Smeat/solder_station/doc/pictures/board.jpg

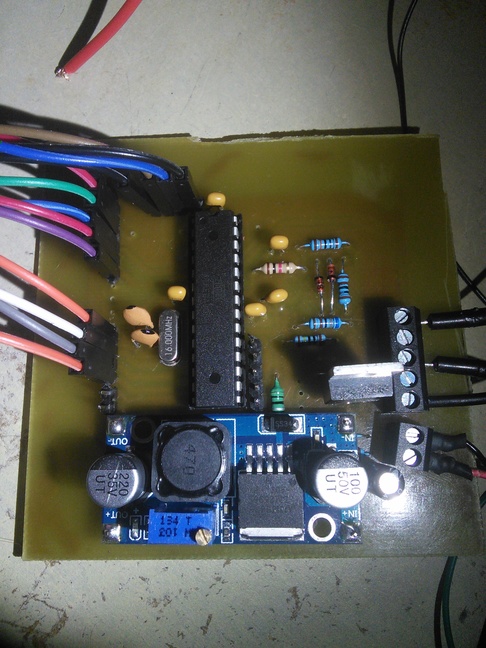
doc/pictures/board.jpg
