Smeat/solder_station/README

The content of the "scad" folder is licensed under the CC-BY-SA-NC 4.0.
The rest, if not stated otherwise, is licensed under the GPLv3.
