Smeat/solder_station/Firmware/README

To use this you have to provide your own library for button detection.
