Smeat/solder_station/doc/ui/ui.pdf

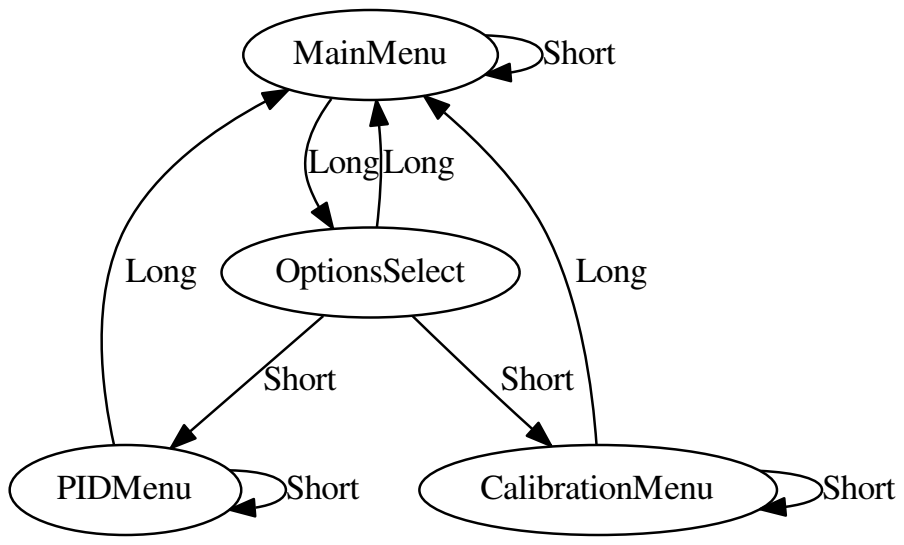
[picture p2: figure]
MainMenu; Short; OptionsSelect; LongLong; PIDMenu; CalibrationMenu; Long
