Smeat/solder_station/scad/stl/TShell.stl

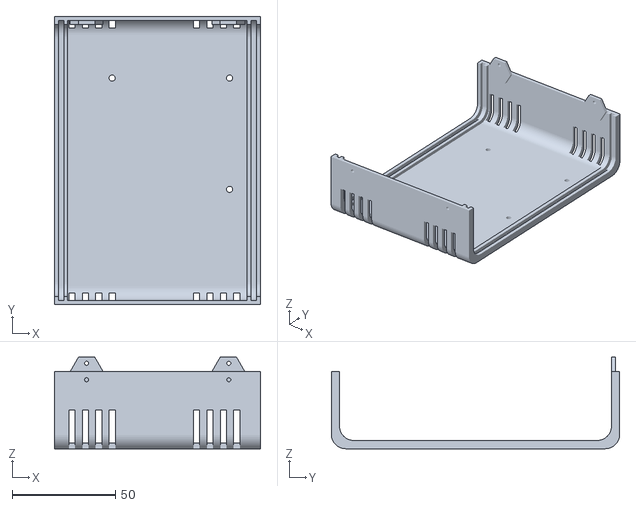
[picture p3: CAD file, 2016-02-08]
scad/stl/TShell.stl
100.0 x 140.0 x 44.4
