Smeat/solder_station/scad/stl/Text.stl

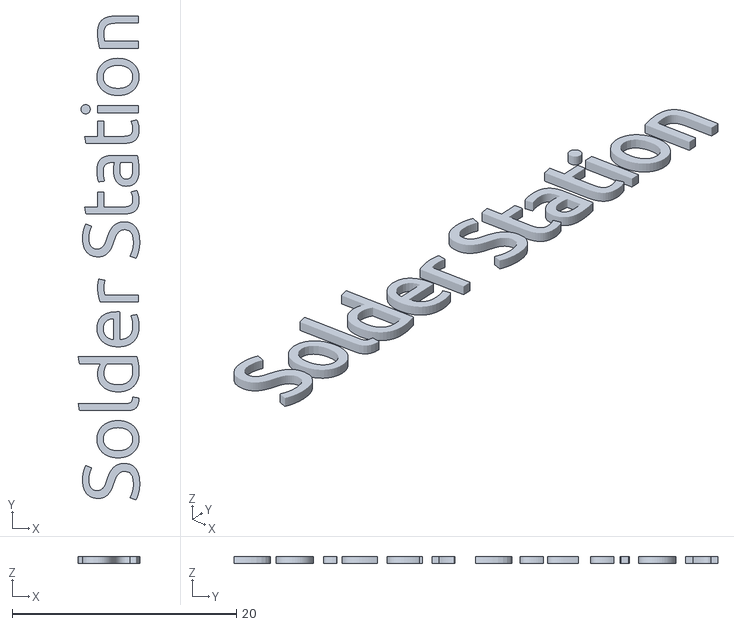
[picture p4: CAD file, 2016-02-08]
scad/stl/Text.stl
5.50 x 43.1 x 0.6
