Smeat/solder_station/scad/stl/BShell.stl

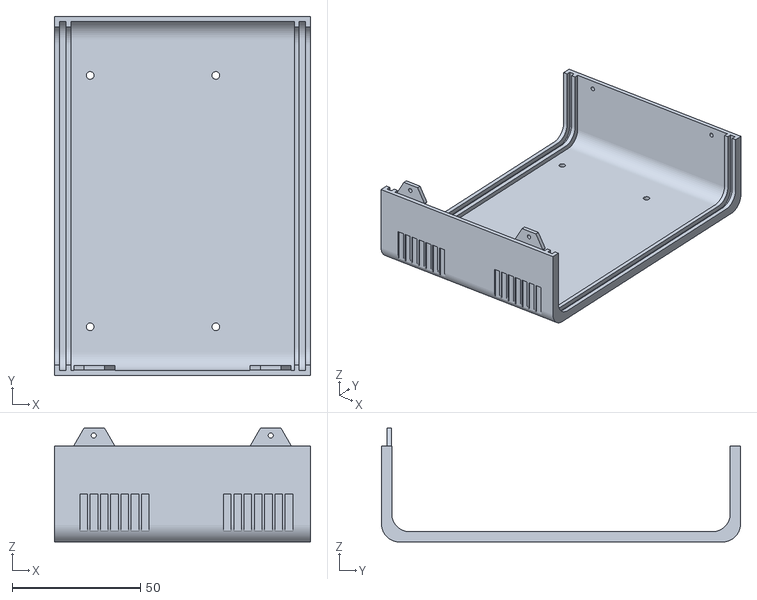
[picture p5: CAD file, 2016-02-08]
scad/stl/BShell.stl
100.0 x 140.0 x 44.4
