Smeat/solder_station/scad/stl/FPanel.stl

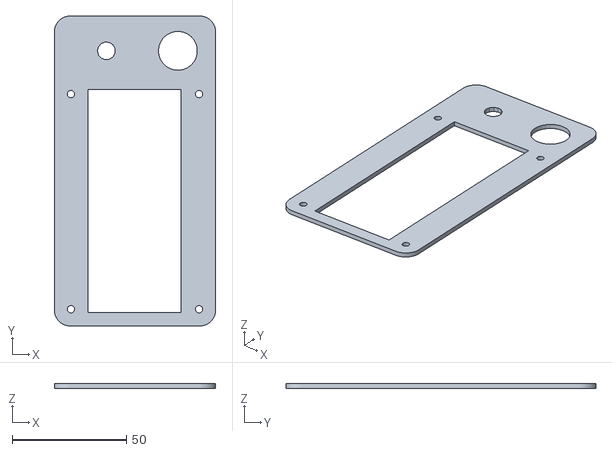
[picture p6: CAD file, 2016-02-08]
scad/stl/FPanel.stl
70.5 x 135.5 x 2.00
