Smeat/solder_station/scad/stl/BPanel.stl

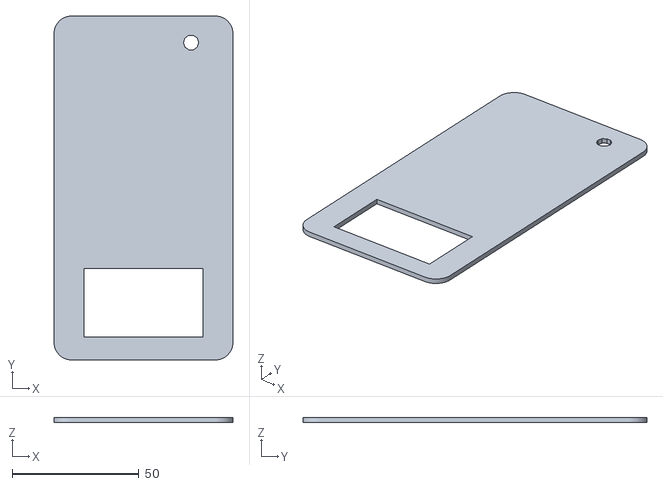
[picture p7: CAD file, 2016-02-08]
scad/stl/BPanel.stl
70.5 x 135.5 x 2.00
