Smeat/solder_station/scad/conf/active_userconfig.scad

include <myconfig.scad>
