Smeat/solder_station/(list of files, cad)

Other CAD files:
scad/vitamins/gx16.scad
