Smeat/solder_station/(threads)

Thread 2 (2016-02-23):

Button implementation is missing

Smeat, 2016-02-23:
