Smeat/solder_station/kicad/solder_station.pdf

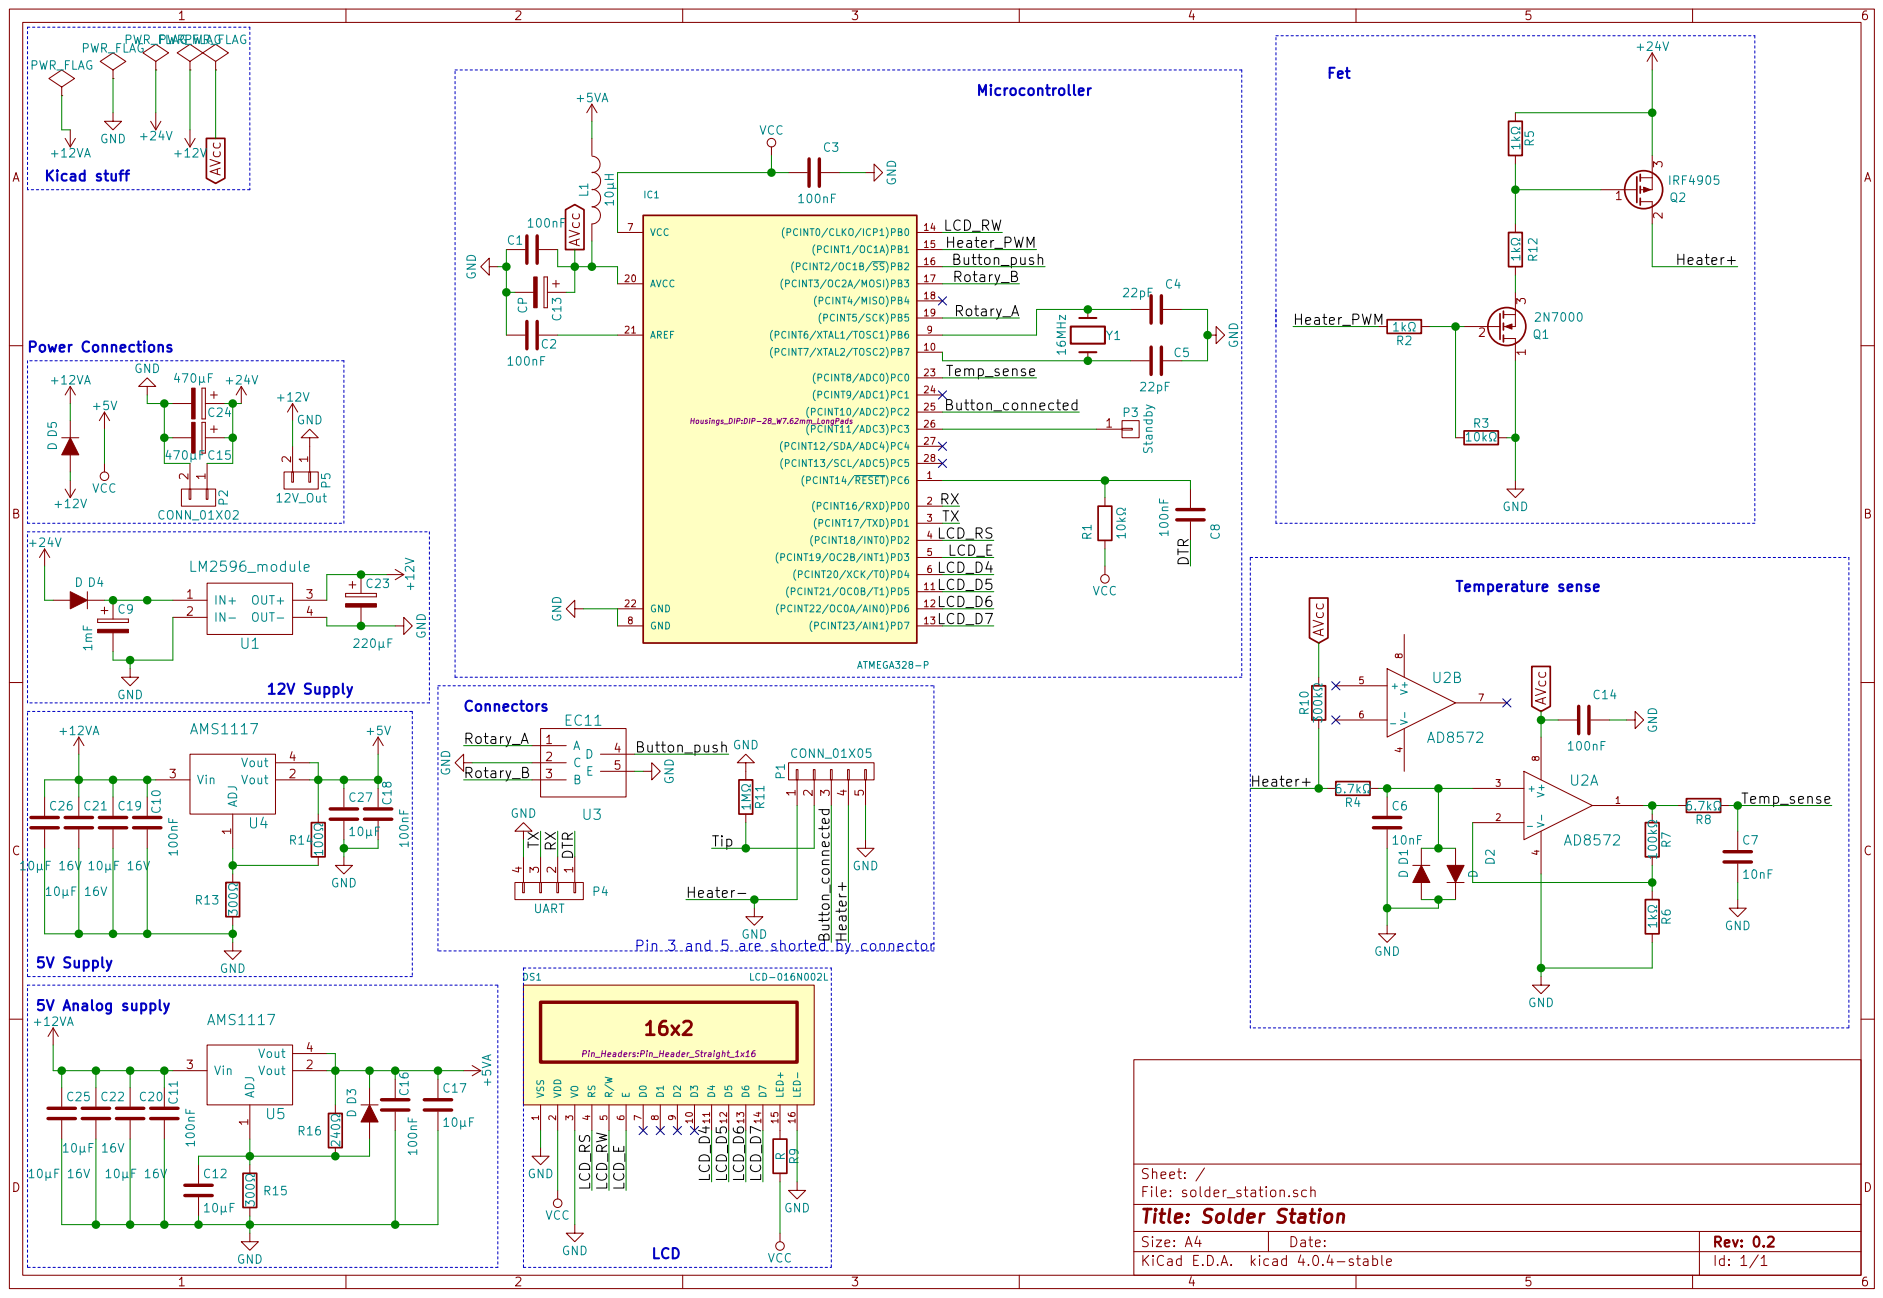
[picture p8: page 1]

1 P4 UART GND C8100nF GND D1 D D2 D R10 300k AVcc 1MR11 Heater- Tip

Pin 3 and 5 are shorted by connector

9 D3 10 D4 11 D5 12 D6 13 D7 14 LED+ 15 LED- 16 DS1 LCD-016N002L Pin_Headers:Pin_Header_Straight_1x16 GND GND

File: solder_station.sch Sheet: /
Id: 1/1 Title: Solder Station
