Smeat/solder_station/kicad/solder_station.kicad_pcb

## KiCad design kicad/solder_station.kicad_pcb (2016-11-06)

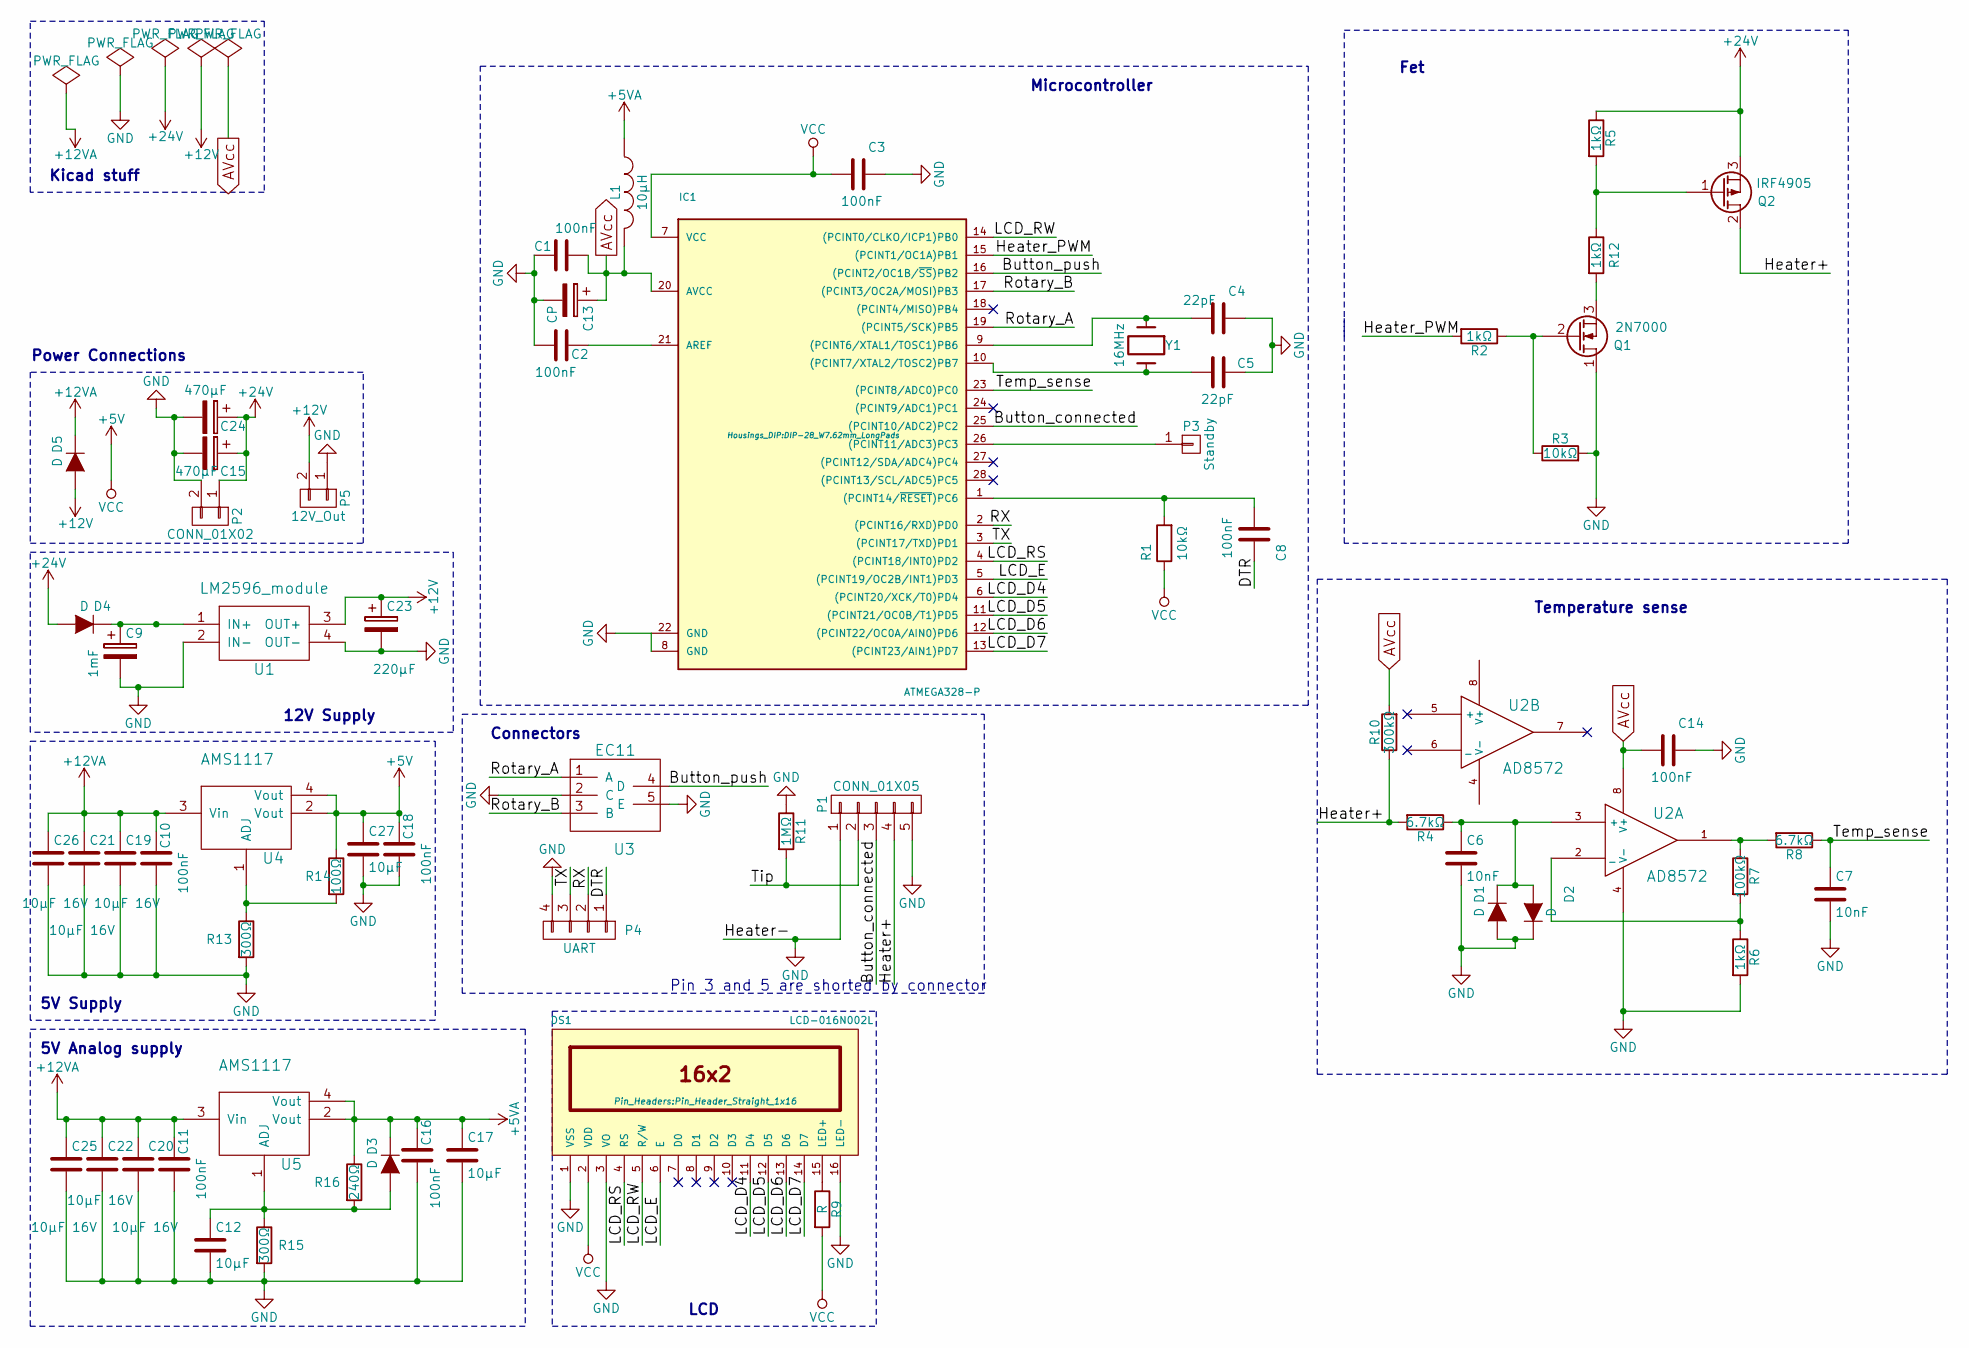
[picture p9: schematic solder_station.sch, Solder Station]

Parts:
C1, C2, C3, C8, C10, C11, C14, C16, C18: 100nF; C_0603
C4, C5: 22pF; C_Disc_D3_P2.5
C6, C7: 10nF; C_0603
C9: 1mF; C_Radial_D10_L25_P5
C12, C17, C27: 10µF; C_0603
C13: CP; C_Radial_D6.3_L11.2_P2.5
C15, C24: 470µF; C_Radial_D6.3_L11.2_P2.5
C19, C20, C21, C22, C25, C26: 10µF 16V; C_0805
C23: 220µF; C_Radial_D6.3_L11.2_P2.5
D1, D2, D3, D4, D5: D; Diode_DO-35_SOD27_Horizontal_RM10
DS1: LCD-016N002L; Pin_Header_Straight_1x16
IC1: ATMEGA328-P; DIP-28_W7.62mm_LongPads
L1: 10µH; Choke_Horizontal_RM10mm
P1: CONN_01X05; TerminalBlock_Pheonix_MKDS1.5-5pol
P2: CONN_01X02; TerminalBlock_Pheonix_MKDS1.5-2pol
P3: Standby; Pin_Header_Straight_1x01
P4: UART; Pin_Header_Straight_1x04
P5: 12V_Out; Pin_Header_Angled_1x02
Q1: 2N7000; TO-92_Inline_Wide
Q2: IRF4905; TO-220_Neutral123_Vertical
R1: 10kΩ; Resistor_Horizontal_RM10mm
R2, R5, R12: 1kΩ; Resistor_Horizontal_RM10mm
R3: 10kΩ; R_0805
R4: 6.7kΩ; R_0805_HandSoldering
R6: 1kΩ; R_0805
R7: 100kΩ; R_0805
R8: 6.7kΩ; Resistor_Horizontal_RM7mm
R9: R; Resistor_Horizontal_RM10mm
R10: 300kΩ; Resistor_Horizontal_RM10mm
R11: 1MΩ; R_0805
R13, R15: 300Ω; R_0805
R14: 100Ω; R_0805
R16: 240Ω; R_0805
U1: LM2596_module; LM2596
U2: AD8572; SOIC-8_3.9x4.9mm_Pitch1.27mm
U3: EC11; Pin_Header_Straight_1x05
U4, U5: AMS1117; SOT-223
Y1: 16MHz; HC-49V

Connections:
+5V: C3.2, C18.1, C27.1, DS1.2 (VDD), IC1.7 (VCC), R1.1, R9.2, R14.1, U4.2 (Vout), U4.4 (Vout)
+5VA: C16.1, C17.1, D3.1 (K), L1.1, R16.1, U5.2 (Vout), U5.4 (Vout)
+12V: C23.1, D5.2 (A), P5.2, U1.3 (OUT+)
+12VA: C10.1, C11.1, C19.1, C20.1, C21.1, C22.1, C25.1, C26.1, D5.1 (K), U4.3 (Vin), U5.3 (Vin)
+24V: C15.1, C24.1, D4.2 (A), P2.1, Q2.3 (S), R5.1
/Button_connected: IC1.25 ((PCINT10/ADC2)PC2), P1.3
/Button_push: IC1.16 ((PCINT2/OC1B/~SS~)PB2), U3.4 (D)
/DTR: C8.1, P4.1
/Heater+: P1.4, Q2.2 (D), R4.2, R10.1
/Heater_PWM: IC1.15 ((PCINT1/OC1A)PB1), R2.2
/LCD_D4: DS1.11 (D4), IC1.6 ((PCINT20/XCK/T0)PD4)
/LCD_D5: DS1.12 (D5), IC1.11 ((PCINT21/OC0B/T1)PD5)
/LCD_D6: DS1.13 (D6), IC1.12 ((PCINT22/OC0A/AIN0)PD6)
/LCD_D7: DS1.14 (D7), IC1.13 ((PCINT23/AIN1)PD7)
/LCD_E: DS1.6 (E), IC1.5 ((PCINT19/OC2B/INT1)PD3)
/LCD_RS: DS1.4 (RS), IC1.4 ((PCINT18/INT0)PD2)
/LCD_RW: DS1.5 (R/W), IC1.14 ((PCINT0/CLKO/ICP1)PB0)
/RX: IC1.2 ((PCINT16/RXD)PD0), P4.2
/Rotary_A: IC1.19 ((PCINT5/SCK)PB5), U3.1 (A)
/Rotary_B: IC1.17 ((PCINT3/OC2A/MOSI)PB3), U3.3 (B)
/TX: IC1.3 ((PCINT17/TXD)PD1), P4.3
/Temp_sense: C7.1, IC1.23 ((PCINT8/ADC0)PC0), R8.1
/Tip: P1.2, R11.2
AVcc: C1.2, C13.1, C14.2, IC1.20 (AVCC), L1.2, R10.2, U2.8 (V+)
GND: C1.1, C2.2, C3.1, C4.1, C5.1, C6.2, C7.2, C9.2, C10.2, C11.2, C12.2, C13.2, C14.1, C15.2, C16.2, C17.2, C18.2, C19.2, C20.2, C21.2, C22.2, C23.2, C24.2, C25.2, C26.2, C27.2, D1.2 (A), D2.1 (K), DS1.1 (VSS), DS1.3 (VO), DS1.16 (LED-), IC1.8 (GND), IC1.22 (GND), P1.1, P1.5, P2.2, P4.4, P5.1, Q1.1 (D), R3.2, R6.2, R11.1, R13.2, R15.2, U1.2 (IN-), U1.4 (OUT-), U2.4 (V-), U3.2 (C), U3.5 (E)
unnamed: C2.1, IC1.21 (AREF)
unnamed: C4.2, IC1.9 ((PCINT6/XTAL1/TOSC1)PB6), Y1.1
unnamed: C5.2, IC1.10 ((PCINT7/XTAL2/TOSC2)PB7), Y1.2
unnamed: C6.1, D1.1 (K), D2.2 (A), R4.1, U2.3 (+)
unnamed: C8.2, IC1.1 ((PCINT14/~RESET~)PC6), R1.2
unnamed: C9.1, D4.1 (K), U1.1 (IN+)
unnamed: C12.1, D3.2 (A), R15.1, R16.2, U5.1 (ADJ)
unnamed: DS1.15 (LED+), R9.1
unnamed: IC1.26 ((PCINT11/ADC3)PC3), P3.1
unnamed: Q1.2 (G), R2.1, R3.1
unnamed: Q1.3 (S), R12.2
unnamed: Q2.1 (G), R5.2, R12.1
unnamed: R6.1, R7.2, U2.2 (_)
unnamed: R7.1, R8.2, U2.1
unnamed: R13.1, R14.2, U4.1 (ADJ)

Notes on the sheet:
Pin 3 and 5 are shorted by connector
5V Analog supply
5V Supply
12V Supply
Power Connections
Kicad stuff
Microcontroller
Connectors
LCD
Fet
Temperature sense

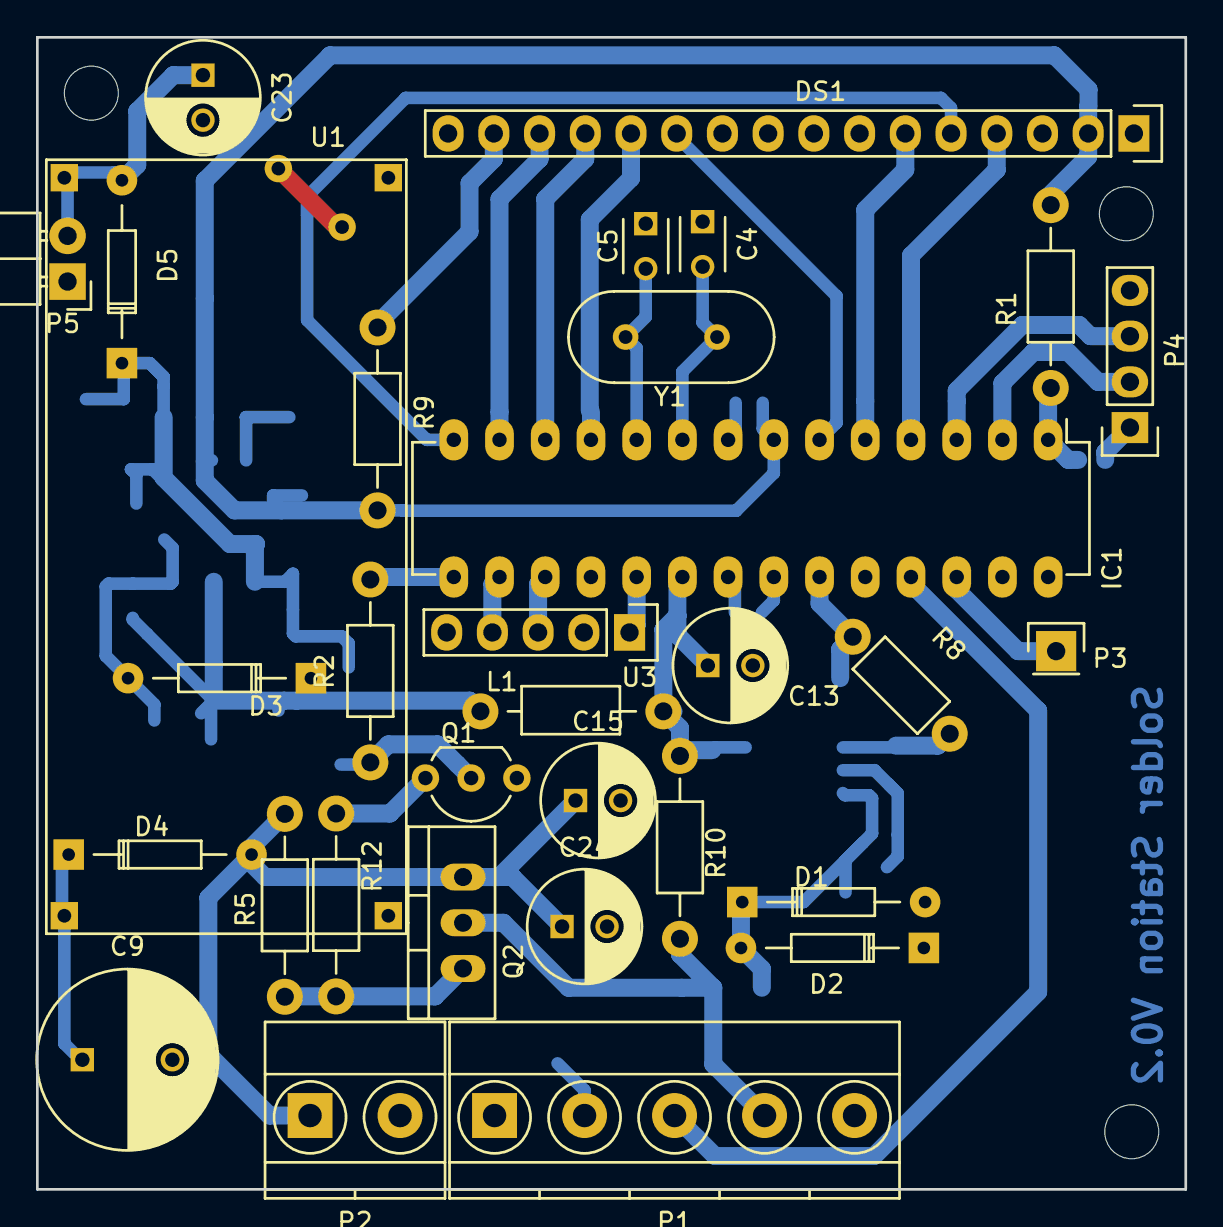
[picture p10: board solder_station.kicad_pcb from above]

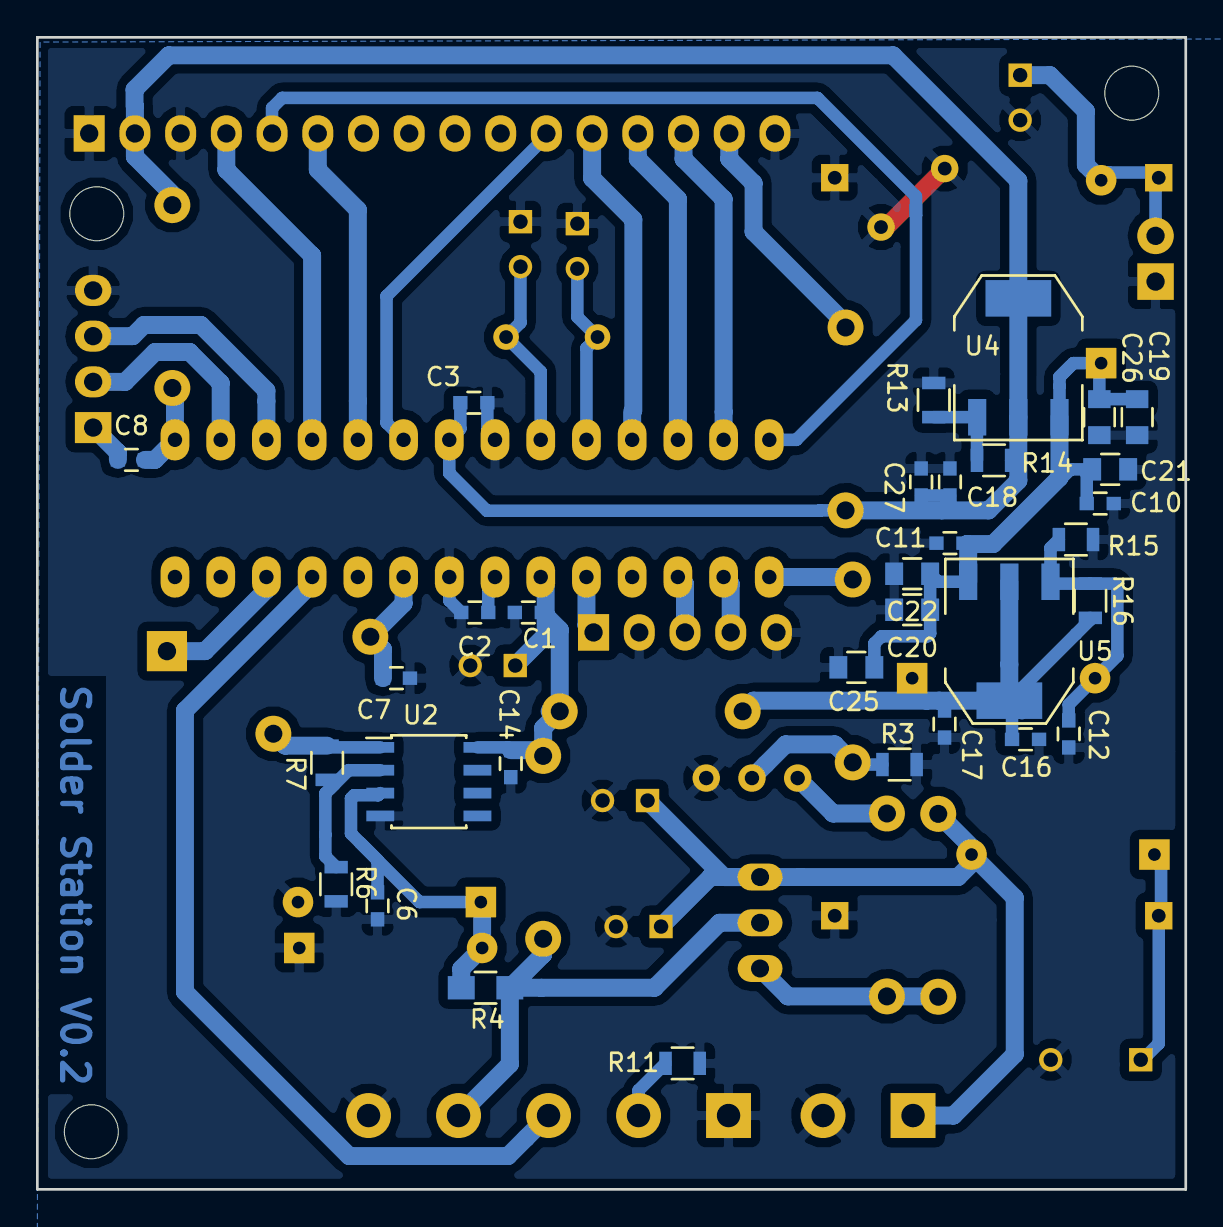
[picture p11: board solder_station.kicad_pcb from below]

Board: 2 copper layers, 63.8 x 64.0 mm, 67 parts (32 on the bottom side), 40 nets.

Other parts of the board:
Hole1, Hole1#2, Hole3: MountingHole_3mm
