Smeat/solder_station/Firmware/src/main.c

/**
This file is part of SolderStation.

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
You should have received a copy of the GNU General Public License
along with SolderStation.  If not, see <http://www.gnu.org/licenses/>.
**/


#include <avr/io.h>
#include <util/delay.h>
#include <avr/interrupt.h>
#include <avr/eeprom.h>

#include <inttypes.h>
#include <stdio.h>
#include <stdlib.h>

#include "../lib/Timer.h"

#include "constants.h"
#include "adc.h"
#include "button.h"

#ifdef LCD_SUPPORT
#include "../lib/lcd/lcd.h"
#endif

#ifdef UART_DEBUG
#include <uart.h>
#endif

#define ROTATE_A ((ROTATE_PIN & (1 << ROTATE_A_PIN)) == 0)
#define ROTATE_B ((ROTATE_PIN & (1 << ROTATE_B_PIN)) == 0)
#define ROTATE_C ((ROTATE_PIN & (1 << ROTATE_C_PIN)) == 0)

#define BUTTON_STANDBY ((BUTTON_STANDBY_PIN_REGISTER & (1 << BUTTON_STANDBY_PIN)) == 0)

#define BUTTON_CONNECTED ((BUTTON_CONNECTED_PIN_REGISTER & (1 << BUTTON_CONNECTED_PIN)) == 0)

uint16_t targetTemp = 0;
uint16_t defaultTemp = 250;
uint16_t standByTemp = 180;
uint16_t lastTemp = 0;


uint16_t EEMEM ee_standByTemp = 180;
uint16_t EEMEM ee_defaultTemp = 250;

float Kp = DEFAULT_KP;
float Ki = DEFAULT_KI;
float Kd = DEFAULT_KD;

float ee_Kp EEMEM = DEFAULT_KP;
float ee_Ki EEMEM = DEFAULT_KI;
float ee_Kd EEMEM = DEFAULT_KD;

float adc_temp_factor = DEFAULT_FACTOR;
int16_t adc_temp_constant = DEFAULT_CONSTANT;

float ee_adc_temp_factor EEMEM = DEFAULT_FACTOR;
int16_t ee_adc_temp_constant EEMEM = DEFAULT_CONSTANT;

float Ki_time = 0;
float Kd_time = 0;
volatile int8_t rotary_value;

uint8_t current_menu = MENU_MAIN;
uint8_t menu_pos = 0;
uint8_t output_enabled = 0;

void setPWM(int16_t val){
	OCR1A = val;
}

#ifdef UART_DEBUG
int uart_putchar(char c, FILE* stream){
	uart_putc(c);
	return 0;
}
#endif

int8_t read_rotary(){
	cli();
	int8_t value = rotary_value;
	rotary_value = value & 0b0011; //save lower bits (e.g. if function returns values less than 4)
	sei();
	return value >> 2;
}

void enableHeater(){
	if(output_enabled){
		TCCR1A |= (1 << COM1A1);
	}
}

void disableHeater(){
	TCCR1A &= ~(1 << COM1A1);
}

uint16_t getTemperature(){
	disableHeater();
	_delay_ms(HEATER_WAIT_DELAY);

	uint16_t avg_adc = read_adc_avg(0, 5);
	float voltage = avg_adc * (1.1 / 1023.0);
	char s[8];
	dtostrf( voltage, 6, 3, s );

	uint16_t temperature = avg_adc * adc_temp_factor + adc_temp_constant;
#ifdef UART_DEBUG_TEMP
	printf("Temp: %u Voltage %s\n", avg_adc, s);
#endif

	enableHeater();

	lastTemp = temperature; //save last temp for display

	return temperature;
}

uint16_t calculatePID(uint16_t target, uint16_t is){
	static uint16_t oldError = 0;
	static float iterm = 0;

	int16_t error = target - is;

	float pterm = Kp * error;
	float dterm = Kd_time * (int16_t)((int16_t)error - (int16_t)oldError);

	if(((pterm + iterm + dterm) < MAX_PWM) && ((pterm + iterm + dterm) > -MAX_PWM)){
		iterm += (Ki_time * error);
	}

	if(error > abs(20)){ //set I to 0 if error is too big
		iterm = 0;
	}

	float output = pterm + iterm + dterm;

	if(output > MAX_PWM) output = MAX_PWM;
	if(output < 0) output = 0;

	oldError = error;

#ifdef UART_DEBUG_PID
	printf("Error: %i ||", error);
	char s[8];
	dtostrf( pterm, 6, 3, s );
	uart_puts(s);
	uart_puts(" + ");
	dtostrf( iterm, 6, 3, s );
	uart_puts(s);
	uart_puts(" + ");

	dtostrf( dterm, 6, 3, s );
	uart_puts(s);
	uart_puts(" = ");
	dtostrf( output, 6, 3, s );
	uart_puts(s);
	uart_puts("\n");
#endif

	return (uint16_t)output;
}

uint8_t isStandby(){
	return BUTTON_STANDBY; //TODO: read button
}

void updateOuput(){
	uint16_t output = calculatePID((isStandby() ? standByTemp : targetTemp), getTemperature());
	setPWM(output);

	if(lastTemp > 400){ //TODO: make variable
		disableHeater();
	}
}

void precalcPID(){
	Ki_time = Ki * updateTime;
	Kd_time = Kd / updateTime;
}

#ifdef LCD_SUPPORT
void init_lcd(){
	lcd_init(LCD_DISP_ON);
	lcd_clrscr();

	lcd_add_custom_character_P(CHARACTER_THERMOMETER, char_thermometer);
	lcd_add_custom_character_P(CHARACTER_DEGREE, char_degree);
	lcd_add_custom_character_P(CHARACTER_KP, char_kp);
	lcd_add_custom_character_P(CHARACTER_KI, char_ki);
	lcd_add_custom_character_P(CHARACTER_KD, char_kd);
	lcd_add_custom_character_P(CHARACTER_PLAY, char_play);
	lcd_add_custom_character_P(CHARACTER_PAUSE, char_pause);
}
#endif

void init_timer(){
	//1ms timer2 TODO: alternative use main loop and millis()?
	TCCR2A = (1 << WGM21); //CTC
	TCCR2B = (1 << CS20) | (1 << CS21); // /64 prescaler
	OCR2A = 250; // 1 ms
	TIMSK2 = (1 << OCIE2A); //enable compare A

	// PWM
	DDRB |= (1 << PB1); //enable output
	TCCR1A = (1<<WGM10) | (1<<WGM11) | (1<<COM1A1); // 10bit-Counter, FastPWM
	TCCR1B =  (1 << CS10) | (1 << CS12) | (1 << WGM12); // 64 prescaler -> 244hz

	init_timer0();

	disableHeater();

	sei();
}

#ifdef LCD_SUPPORT
void updateDisplay(){
	lcd_clrscr();
	lcd_home();
	char menu_string[60];
	uint8_t cursor_end_pos[2] = {0,0};
	if(current_menu == MENU_MAIN){
		lcd_command(LCD_DISP_ON);
		lcd_puts_P("Solder Station 0.1");
		lcd_gotoxy(0,1);

		sprintf(menu_string, "%c%-3u/%-3u%cC \n"
							 "%c\n"
							  "PWM: %-4u\n",
							  CHARACTER_THERMOMETER, lastTemp, targetTemp, CHARACTER_DEGREE, output_enabled ? CHARACTER_PLAY : CHARACTER_PAUSE, output_enabled ? OCR1A : 0);
	}
	else if (current_menu == MENU_OPTIONS_PID){
		lcd_command(LCD_DISP_ON_CURSOR);

		char kp[8], ki[8], kd[8];
		dtostrf( Kp, 6, 1, kp );
		dtostrf( Ki, 6, 2, ki );
		dtostrf( Kd, 6, 1, kd );


		sprintf(menu_string, "PID Setting\n"
							 "%c%-3u/%-3u%cC\n"
							 "%c:%-3s %c:%-3s \n%c:%-3s\n",  CHARACTER_THERMOMETER, lastTemp, targetTemp, CHARACTER_DEGREE,
							 	 	 	 	 	   CHARACTER_KP, kp, CHARACTER_KI, ki, CHARACTER_KD, kd);

		if(menu_pos == 0){ //TODO: make me better. array?
			cursor_end_pos[0] = 7;
			cursor_end_pos[1] = 2;
		}
		else if(menu_pos == 1) {
			cursor_end_pos[0] = 16;
			cursor_end_pos[1] = 2;
		}
		else if(menu_pos == 2){
			cursor_end_pos[0] = 7;
			cursor_end_pos[1] = 3;
		}
	}
	else if (current_menu == MENU_CONNECTED){
		sprintf(menu_string,"Error!\nSolder iron\nnot connected!!\nPlease connect!\n");
	}
	else if (current_menu == MENU_OPTIONS_SELECT){
		sprintf(menu_string, "Select Menu:\n"
				"%s", option_menus[menu_pos]);
	}
	else if (current_menu == MENU_OPTIONS_CALIBRATE){
		lcd_command(LCD_DISP_ON_CURSOR);
		char factor[8];
		dtostrf( adc_temp_factor, 6, 3, factor );

		sprintf(menu_string, "Calibration\n"
							 "%c%-3u/%-3u%cC\n"
							 "Factor: %s\n"
							 "Constant: %i",
							 CHARACTER_THERMOMETER, lastTemp, targetTemp, CHARACTER_DEGREE,
							 factor, adc_temp_constant);
		if(menu_pos == 0){
			cursor_end_pos[0] = 13;
			cursor_end_pos[1] = 2;
		}
		else if(menu_pos == 1){
			cursor_end_pos[0] = 11;
			cursor_end_pos[1] = 3;
		}
	}
	else if(current_menu == MENU_OPTIONS_RESET){
		sprintf(menu_string, "Reset defaults\n"
							 "Are you sure?\n"
							 "Press long to abort\n"
							 "%s  %s  %s", (menu_pos) == 1 ? "2" : "", (menu_pos) == 2 ? "1" : "", (menu_pos) == 3 ? "0" : "");
	}
	else if(current_menu == MENU_OPTIONS_TEMP){
		lcd_command(LCD_DISP_ON_CURSOR);
		sprintf(menu_string,"Set temperatures\n"
							"StartTemp: %-3u%cC\n"
							"Standby: %-3u%cC", defaultTemp, CHARACTER_DEGREE, standByTemp, CHARACTER_DEGREE);
		if(menu_pos == 0){
			cursor_end_pos[0] =  13;
			cursor_end_pos[1] = 1;
		}
		if(menu_pos == 1){
			cursor_end_pos[0] =  11;
			cursor_end_pos[1] = 2;
		}
	}

	lcd_puts(menu_string);
	lcd_gotoxy(cursor_end_pos[0],cursor_end_pos[1]);
}
#endif

void init_io(){
	 ROTATE_DDR &=~ (1 << ROTATE_A_PIN);
	 ROTATE_DDR &=~ (1 << ROTATE_B_PIN);
	 ROTATE_DDR &=~ (1 << ROTATE_C_PIN);
	 ROTATE_PORT |= (1 << ROTATE_A_PIN) | (1 << ROTATE_B_PIN) | (1 << ROTATE_C_PIN);
	 BUTTON_STANDBY_DDR &=~(1 << BUTTON_STANDBY_PIN);
	 BUTTON_STANDBY_PORT |= (1 << BUTTON_STANDBY_PIN);

	 BUTTON_CONNECTED_DDR &= ~(1 << BUTTON_CONNECTED_PIN);
	 BUTTON_CONNECTED_PORT |= (1 << BUTTON_CONNECTED_PIN);
}

#ifdef UART_DEBUG
void init_uart(){
	uart_init(UART_BAUD_SELECT(9600L, F_CPU));

	fdevopen( &uart_putchar, 0 );

	printf("UART Begin!\n");
}
#endif

ISR(TIMER2_COMPA_vect){
	static uint8_t ms = 0;
	uint8_t val, diff;
	static uint8_t last = 0;
	val = 0;
	if( ROTATE_A )
		val = 0b0011;
	if( ROTATE_B )
		val ^= 1;
	diff = last - val;
	if( diff & 1 ){ //bit 0 changed -> rotated
		last = val;
		rotary_value += (diff & 0b0010) - 1; //bit 1 = direction
	}
	if(++ms >=10){
		update_key();
		ms = 0;
	}
}

void saveEEPROMDefault(){
	cli();
	eeprom_update_float(&ee_Kp, DEFAULT_KP);
	eeprom_update_float(&ee_Ki, DEFAULT_KI);
	eeprom_update_float(&ee_Kd, DEFAULT_KD);
	eeprom_update_float(&ee_adc_temp_factor, DEFAULT_FACTOR);
	eeprom_update_word((uint16_t*)&ee_adc_temp_constant, (uint16_t)DEFAULT_CONSTANT);
	eeprom_update_word(&ee_standByTemp, 180);
	eeprom_update_word(&ee_defaultTemp, 250);
	sei();

	precalcPID();
}


void saveEEPROM(){
	cli();
	eeprom_update_float(&ee_Kp, Kp);
	eeprom_update_float(&ee_Ki, Ki);
	eeprom_update_float(&ee_Kd, Kd);
	eeprom_update_float(&ee_adc_temp_factor, adc_temp_factor);
	eeprom_update_word((uint16_t*)&ee_adc_temp_constant, (uint16_t)adc_temp_constant);
	eeprom_update_word(&ee_standByTemp, standByTemp);
	eeprom_update_word(&ee_defaultTemp, defaultTemp);
	sei();
}

void loadEEPROM(){
	cli();
	if((Kp = eeprom_read_float(&ee_Kp)) == EEPROM_DEF){
		Kp = DEFAULT_KP; //FIXME: this is not working
	}
	if((Ki = eeprom_read_float(&ee_Ki)) == EEPROM_DEF){
		Ki = DEFAULT_KI;
	}
	if((Kd = eeprom_read_float(&ee_Kd)) == EEPROM_DEF){
		Kd = DEFAULT_KD;
	}
	if((adc_temp_factor = eeprom_read_float(&ee_adc_temp_factor)) == EEPROM_DEF){
		adc_temp_factor = DEFAULT_FACTOR;
	}
	if((adc_temp_constant = eeprom_read_word((uint16_t*)&ee_adc_temp_constant)) == EEPROM_DEF){
		adc_temp_constant = DEFAULT_CONSTANT;
	}
	if((defaultTemp = eeprom_read_word(&ee_defaultTemp)) == EEPROM_DEF){
		defaultTemp = 250;
	}
	if((standByTemp = eeprom_read_word(&ee_standByTemp)) == EEPROM_DEF){
		standByTemp = 180;
	}
	sei();

	precalcPID();
}

void processInput(){
	int8_t button_rotation = read_rotary();

	uint8_t key_pressed_long =  get_key_long(1 << KEY0);
	uint8_t key_pressed_short = get_key_short(1 << KEY0);

#ifdef UART_DEBUG_INPUT
	printf("Buttons: A %u B %u long %u short %u\n", ROTATE_A, ROTATE_B, key_pressed_long, key_pressed_short);
#endif

	if(current_menu == MENU_CONNECTED && BUTTON_CONNECTED){
		current_menu = MENU_MAIN;
	}

	if(!BUTTON_CONNECTED){
		current_menu = MENU_CONNECTED;
	}

	else if(current_menu == MENU_MAIN){ //do this if we are in main menu
		targetTemp += button_rotation;
		if(key_pressed_long){
			current_menu = MENU_OPTIONS_SELECT; //button pressed -> switch to options menu
		}
		else if(key_pressed_short){
			output_enabled = !output_enabled;
			printf("Toggle heater\n");
			if(output_enabled){
				enableHeater();
			}
			else {
				disableHeater();
			}
		}
	}
	else if(current_menu == MENU_OPTIONS_PID){ //do this if we are in options menu

		if(menu_pos == 0){
			Kp += 0.1 * button_rotation;
		}
		if(menu_pos == 1){
			Ki += 0.01 * button_rotation;
			precalcPID();
		}
		if(menu_pos == 2){
			Kd += 0.1 * button_rotation;
			precalcPID();
		}

		if(key_pressed_short){ //button pressed -> go to next item
			if(++menu_pos == MENU_OPTIONS_PID_LAST_ITEM){ //last item -> exit and save to eeprom
				menu_pos = 0;
			}
		}
		else if(key_pressed_long){
			current_menu = MENU_MAIN;
			menu_pos = 0;
			saveEEPROM();
		}
	}
	else if(current_menu == MENU_OPTIONS_SELECT){
		menu_pos += button_rotation;//key pressed short -> toggle menu
		menu_pos = menu_pos % NUM_MENU_OPTIONS; //TODO: allow reverse
#ifdef UART_DEBUG_INPUT
		printf("Current menu pos: %u\n", menu_pos);
#endif

		if(key_pressed_short){ //go to selected menu
			if(menu_pos == 0) current_menu = MENU_OPTIONS_PID;
			if(menu_pos == 1) current_menu = MENU_OPTIONS_CALIBRATE;
			if(menu_pos == 2) current_menu = MENU_OPTIONS_TEMP;
			if(menu_pos == 3) current_menu = MENU_OPTIONS_RESET;

			menu_pos = 0;
		}
		else if(key_pressed_long){
			current_menu = MENU_MAIN;
			menu_pos = 0;
		}
	}
	else if(current_menu == MENU_OPTIONS_CALIBRATE){ //temp calibration menu

		if(menu_pos == 0){
			adc_temp_factor += 0.001 * button_rotation;
		}
		else if(menu_pos == 1){
			adc_temp_constant += button_rotation;
		}


		if(key_pressed_short){ //button pressed -> go to next item
			if(++menu_pos == MENU_OPTIONS_CALIBRATE_LAST_ITEM){ //last item -> exit and save to eeprom
				menu_pos = 0;
			}
		}
		else if(key_pressed_long){
			current_menu = MENU_MAIN;
			menu_pos = 0;
			saveEEPROM();
		}
	}
	else if(current_menu == MENU_OPTIONS_RESET){

		if(key_pressed_short){
			if(++menu_pos >3){
				menu_pos = 0;
				saveEEPROMDefault();
				loadEEPROM();
				current_menu = MENU_MAIN;
			}
		}
		else if(key_pressed_long){
			current_menu = MENU_MAIN;
			menu_pos = 0;
		}
	}
	else if(current_menu == MENU_OPTIONS_TEMP){

		if(menu_pos == 0){
			defaultTemp += button_rotation;
		}

		if(menu_pos == 1){
			standByTemp += button_rotation;
		}

		if(key_pressed_short){
			if(++menu_pos >=2){
				menu_pos = 0;
			}
		}
		else if(key_pressed_long){
			current_menu = MENU_MAIN;
			menu_pos = 0;
			saveEEPROM();
		}
	}
}

int main(){
#ifdef UART_DEBUG
	init_uart();
#endif
#ifdef LCD_SUPPORT
	init_lcd();
#endif
	init_timer();
	init_adc();
	init_io();




	//saveEEPROM();

	loadEEPROM();

	precalcPID();

	targetTemp = defaultTemp;

	uint32_t lastUpdate = 0;
	uint32_t lastDisplayUpdate = 0;

	uint16_t updateInterval = (uint16_t)  (updateTime * 1000.0);

	while(1){
		if( (millis() - lastUpdate) > updateInterval){
			lastUpdate = millis();
			processInput();
			updateOuput();
		}
#ifdef LCD_SUPPORT
		if( (millis() - lastDisplayUpdate) > 200){
			lastDisplayUpdate = millis();
			updateDisplay();
		}

#endif
	}
}
