Smeat/solder_station/(commit log)

2015-12-11 First commit.
    [solder_station.kicad_pcb, solder_station.sch]
2016-01-17 First version of the 3D model.
    [config.scad, gx16.scad, hd44780.scad, main_box.scad]
2016-01-17 Update schematic.
    [solder_station.sch]
2016-01-17 Kicad file update.
2016-01-17 Update make_box script and add 3D files.
    [BPanel.stl, BShell.stl, FPanel.amf, FPanel.stl, TShell.stl, Text.stl]
2016-01-17 Update Box. New Option: top_slots and font_layers.
    [BPanel.stl, BShell.stl, FPanel.stl, TShell.stl, Text.stl, main_box.scad]
2016-01-17 New structure for configs.
    [active_userconfig.scad, config.scad, gx16.scad, hd44780.scad, main_box.scad]
2016-01-21 Update kicad schematics (still incomplete).
    [solder_station.sch]
2016-01-23 Update Schematics.
    [solder_station.sch]
2016-01-27 [Kicad] Update Schematics. Use local labels.
    [solder_station.sch]
2016-01-27 [Kicad] First (bad) version of the PCB.
    [solder_station.kicad_pcb]
2016-01-27 [Kicad] Fix bug in schematics (VGS too high). Still not sure if it is okay this way.
    [solder_station.kicad_pcb, solder_station.sch]
2016-02-06 [Kicad] Update schematics. Using ad8551.
    [solder_station.kicad_pcb, solder_station.sch]
2016-02-06 [Doc] Add picture of the control board.
2016-02-07 [Firmware] Add new calibration menu.
2016-02-07 [Scad] Add pcb mounting holes.
    [config.scad, knob.scad, main_box.scad, main_pcb.scad, power_pcb.scad]
2016-02-07 [Scad] Add fx-9501 handle for future use.
    [hakko-fx9501.scad]
2016-02-08 [Scad] Add screw holes.
    [BPanel.stl, BShell.stl, FPanel.amf, FPanel.stl, TShell.stl, Text.stl, config.scad, hd44780.scad]
2016-02-08 [Firmware] Add options menu for temperatures.
2016-02-23 [Kicad] Update schematics. Use smd capacitors. Add big capacitor for 24V input. Add first approach to fix #1 (still incomplete. Needs testing).
    [solder_station.kicad_pcb, solder_station.sch]
2016-03-02 [Kicad] Use more capacitors and smd parts
    [solder_station.kicad_pcb, solder_station.sch]
2016-03-02 [Kicad] Update (forgot to save).
    [solder_station.kicad_pcb, solder_station.sch]
2016-03-02 [Kicad] Update schematics pdf.
2016-03-02 [Kicad] Add resistor values for voltage regulators.
    [solder_station.sch]
2016-03-03 [Kicad] Add a few more capacitors.
    [solder_station.kicad_pcb, solder_station.sch]
2016-03-03 [Kicad] Move references.
    [solder_station.kicad_pcb]
2016-11-06 [Kicad] Small updates
    [solder_station.kicad_pcb, solder_station.sch]
